techstudycell/LoRa-Project-with-ESP8266-Arduino-control-Relay/Picture/components for transmitter.png

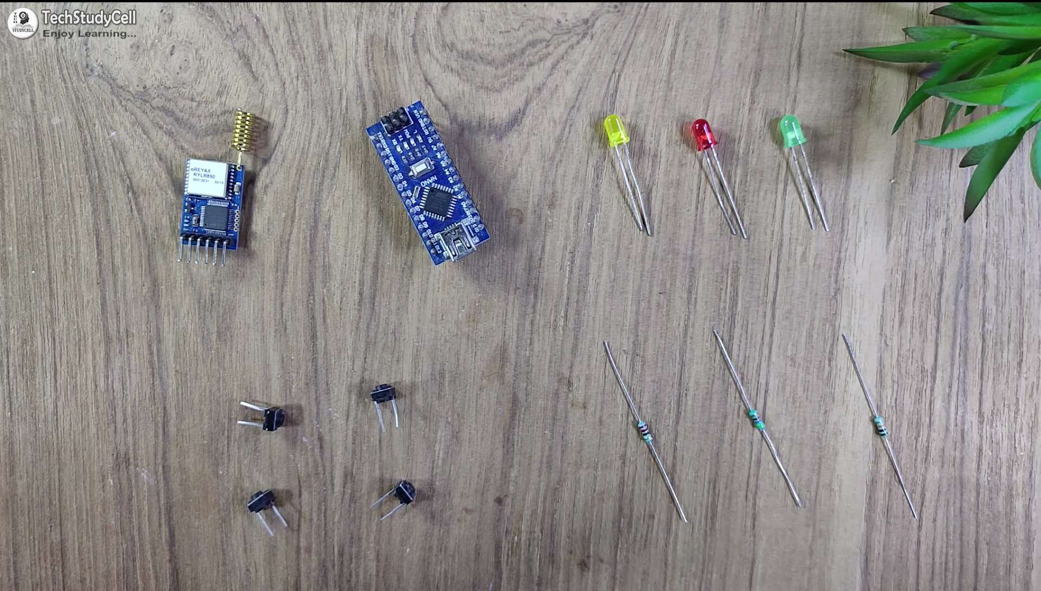
Picture/components for transmitter.png
