techstudycell/LoRa-Project-with-ESP8266-Arduino-control-Relay/Picture/components for receiver.png

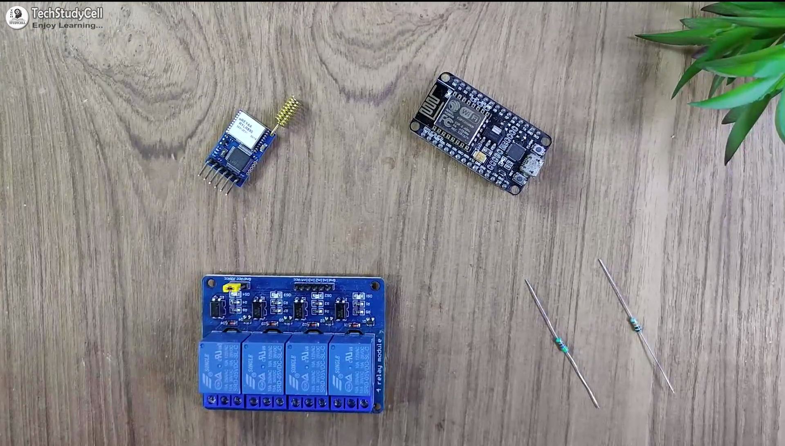
Picture/components for receiver.png
