techstudycell/LoRa-Project-with-ESP8266-Arduino-control-Relay/Circuit/receiver lora esp8266 circuit.jpg

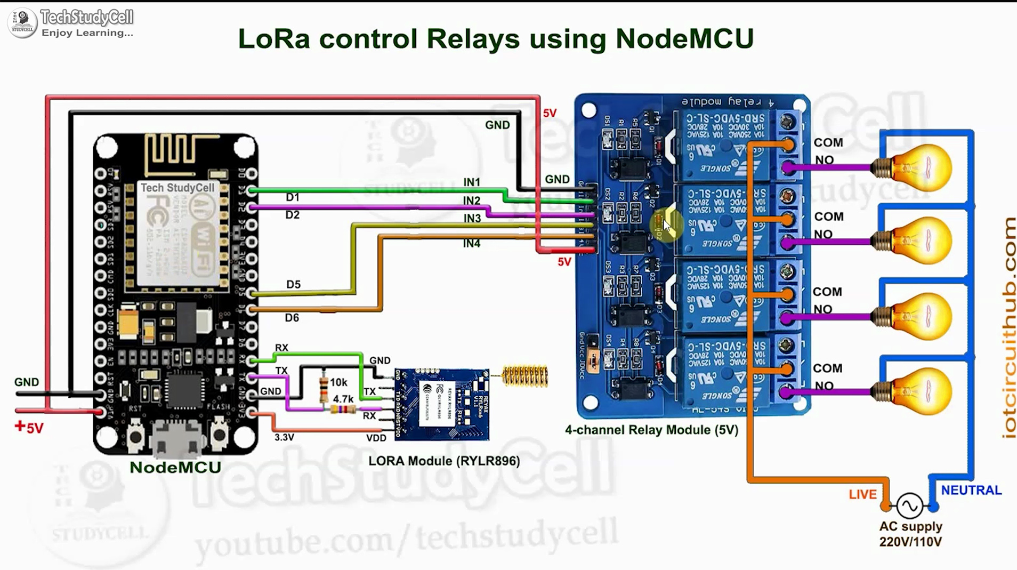
Circuit/receiver lora esp8266 circuit.jpg
