techstudycell/LoRa-Project-with-ESP8266-Arduino-control-Relay/Circuit/REYAX RYLR896 FTDI232.png

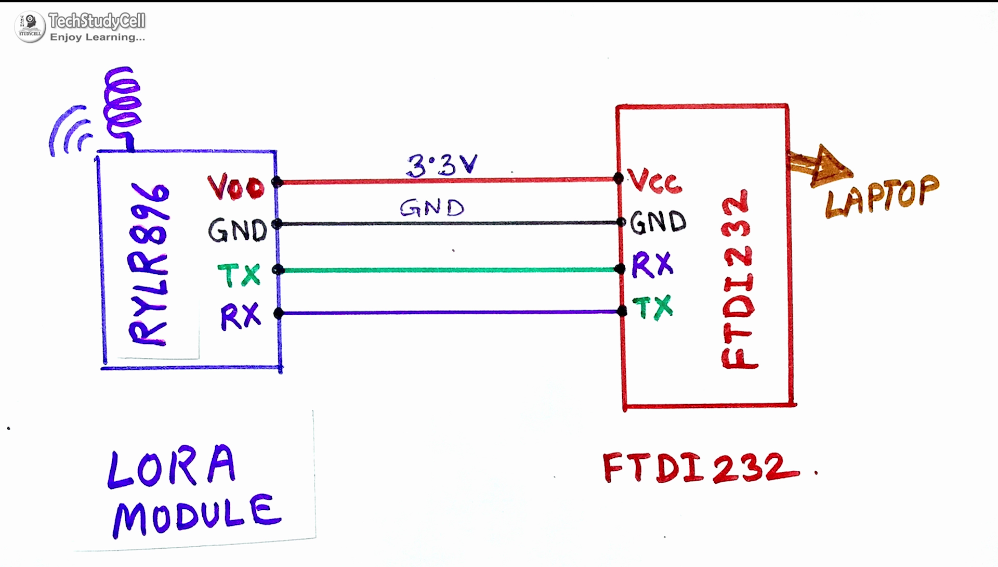
Circuit/REYAX RYLR896 FTDI232.png
