techstudycell/LoRa-Project-with-ESP8266-Arduino-control-Relay/Circuit/transmitter lora arduino circuit.jpg

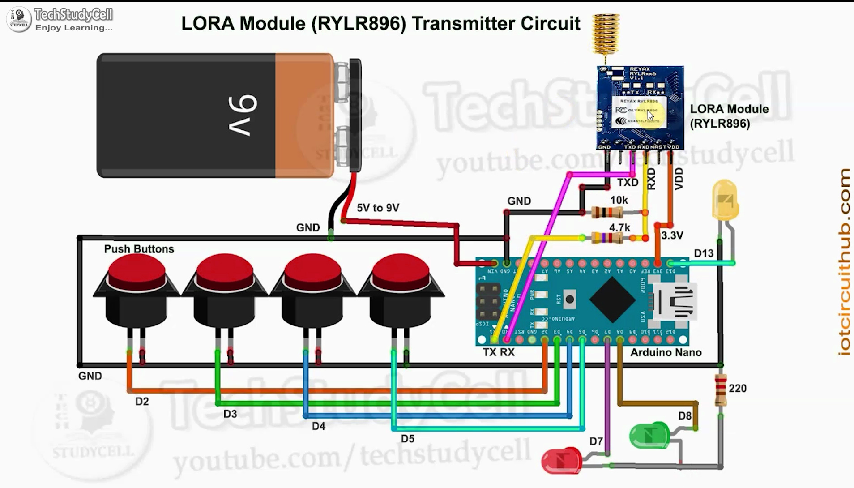
Circuit/transmitter lora arduino circuit.jpg
