techstudycell/LoRa-Project-with-ESP8266-Arduino-control-Relay/Picture/AT commands.JPG

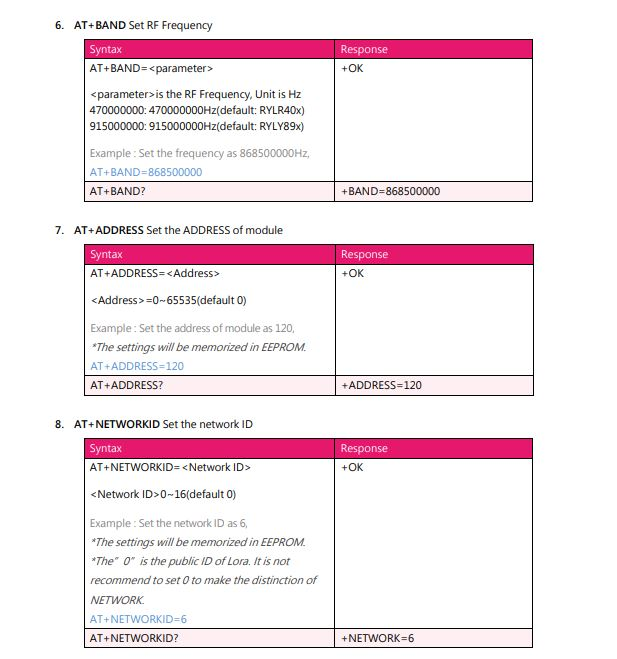
Picture/AT commands.JPG
