techstudycell/LoRa-Project-with-ESP8266-Arduino-control-Relay/Picture/Lora Project P4.png

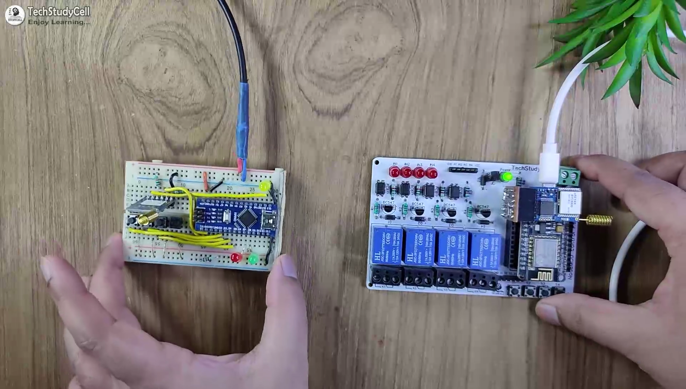
Picture/Lora Project P4.png
