techstudycell/LoRa-Project-with-ESP8266-Arduino-control-Relay/Picture/Lora Project.jpg

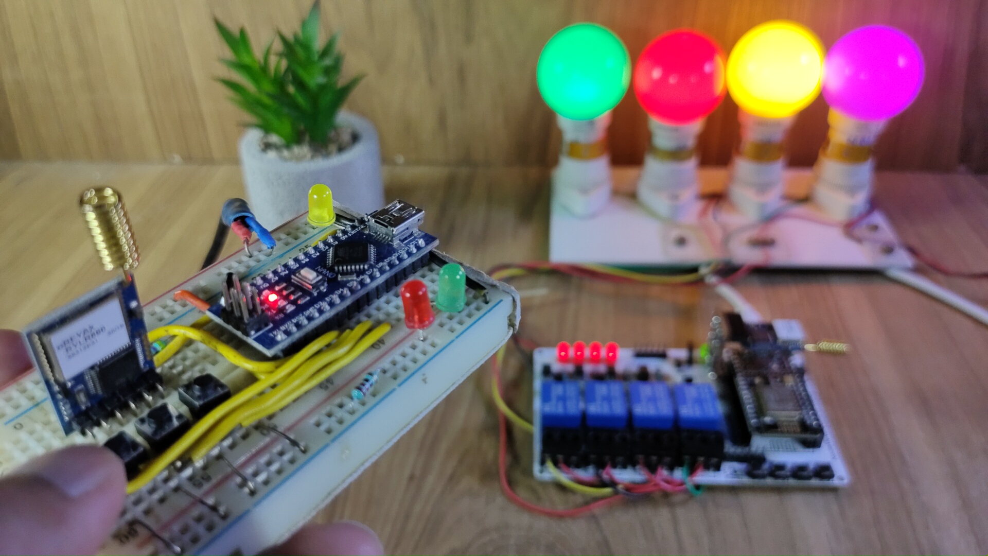
Picture/Lora Project.jpg
