techstudycell/LoRa-Project-with-ESP8266-Arduino-control-Relay/Picture/Lora ProjectP3.png

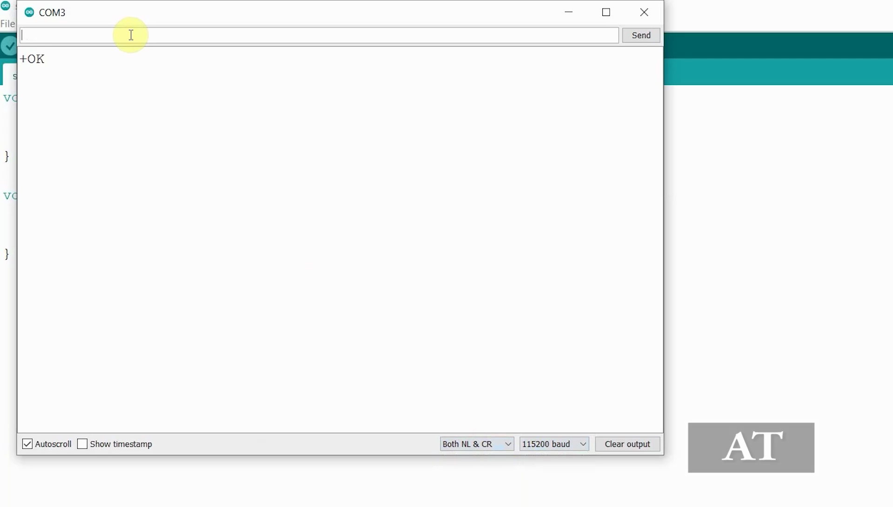
Picture/Lora ProjectP3.png
