techstudycell/LoRa-Project-with-ESP8266-Arduino-control-Relay/Picture/receiving lora pcb.JPG

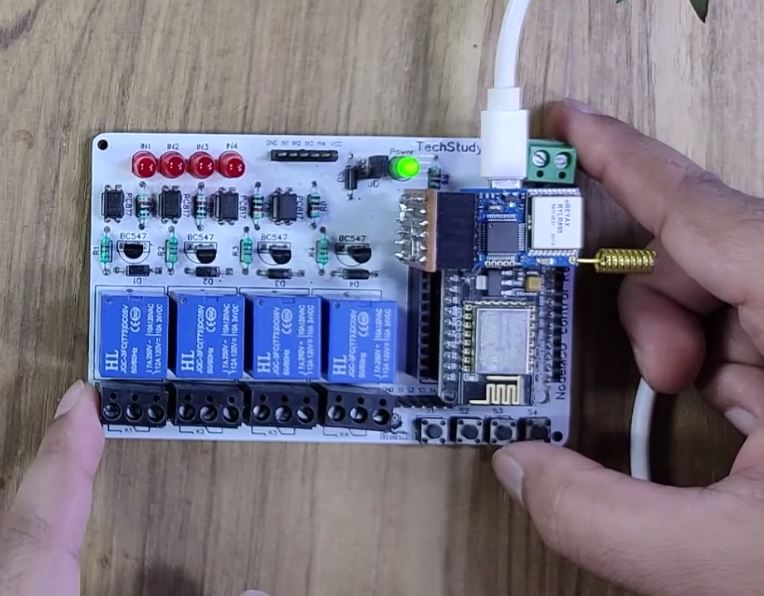
Picture/receiving lora pcb.JPG
