techstudycell/LoRa-Project-with-ESP8266-Arduino-control-Relay/Picture/transmitter lora.png

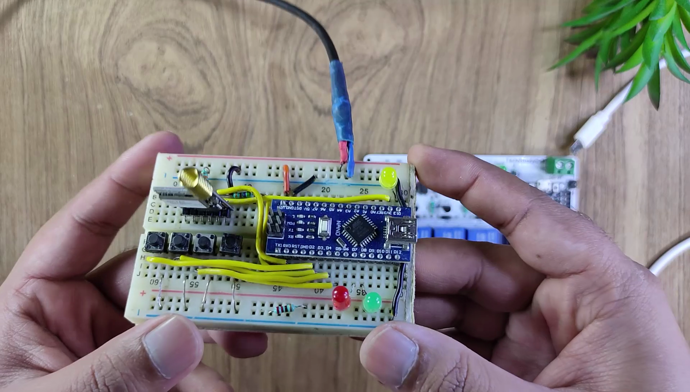
Picture/transmitter lora.png
